cuongtv89ks/smart_wearable_controlling_system_by_hand_and_fingers_gestures/source/glove_python/seminar 18.pptx

## Seminar 18

UBIQUITOUS SENSOR NETWORK LABORATORY

Department of Electronics Engineering, Keimyung University
10th March 2017
By Tran Viet Cuong

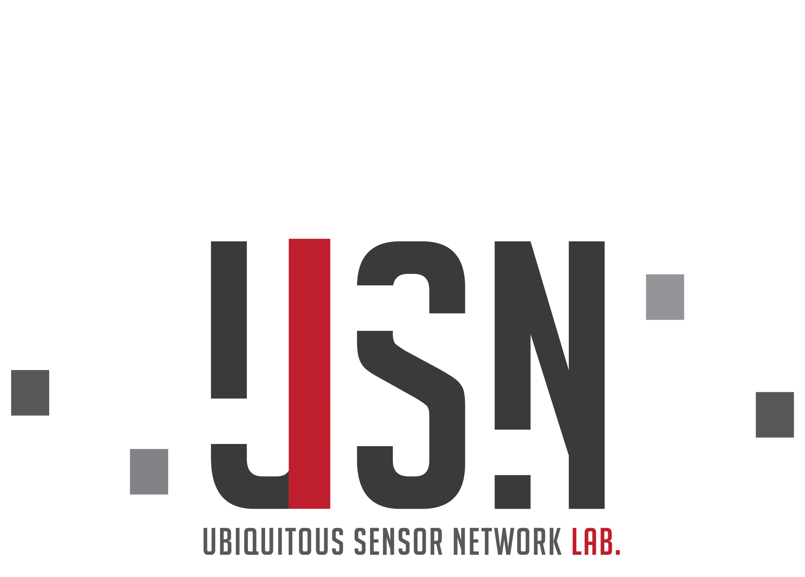
[picture p3: figure]

## Ring Gesture

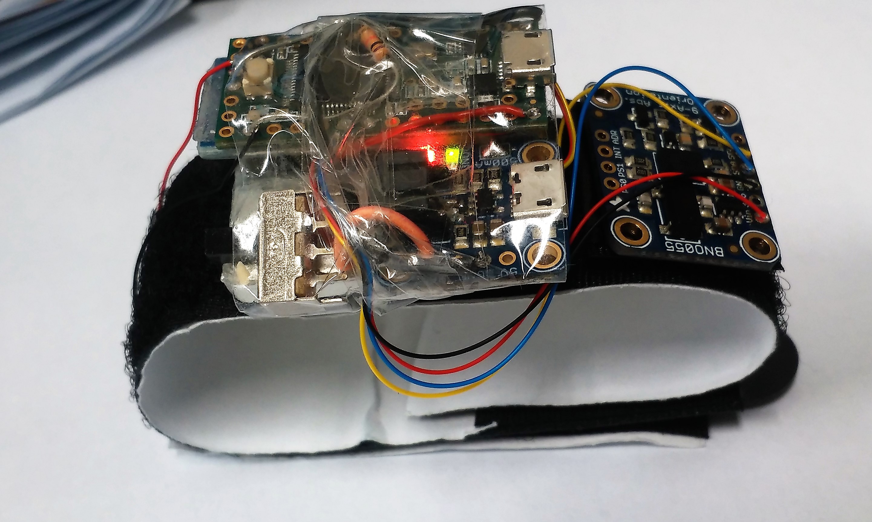
[picture p4: figure]
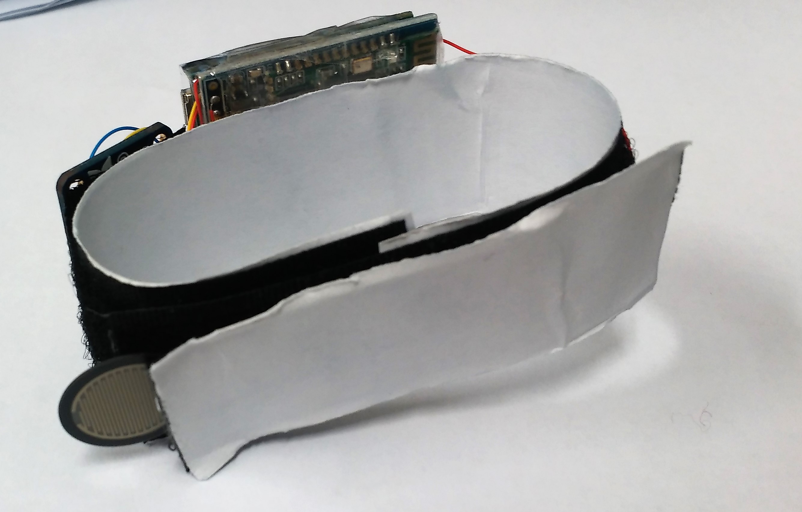
[picture p5: figure]

## The remaining work for ring gesture project:

- Clustering the data
- Try to make standalone system (ARM 32bit, C++)
- Application: Control quadcopter and Home Automation
- 3D printer and PCB board

## Next

- Finish paper
- Learn more deeply into C++, Qt platform
- Build quadcopter

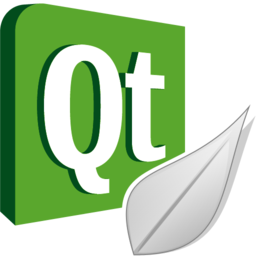
[picture p6: figure]
Image result for Qt platform

## THANK YOU!

UBIQUITOUS SENSOR NETWORK LABORATORY

## Any Questions ?

UBIQUITOUS SENSOR NETWORK LABORATORY
