cuongtv89ks/smart_wearable_controlling_system_by_hand_and_fingers_gestures/thesis/thesis_presentation.pdf

## Tran, Viet Cuong

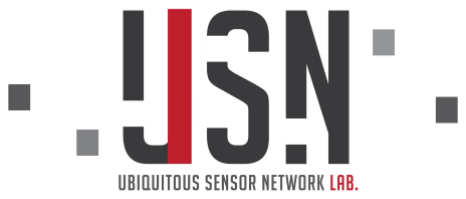
[picture p7: figure]

Department of Electronics Engineering, Keimyung University Daegu, Korea
25th October 2017

# Smart Wearable Controlling System by Hand and Finger Gestures

# Content

# •Introduction

# - System Design

# - Method

# - Experiments and Results

# - Conclusion & Future Work

Smart Wearable Controlling System by Hand and Fingers Gestures | 2

# Content

# •Introduction

# - Gesture Recognition

# - Literature View

# - Smart Wearable Controlling System

# - System Design

# - Evaluation Result

# - Conclusion & future work

Smart Wearable Controlling System by Hand and Fingers Gestures | 3

# Gesture Recognition

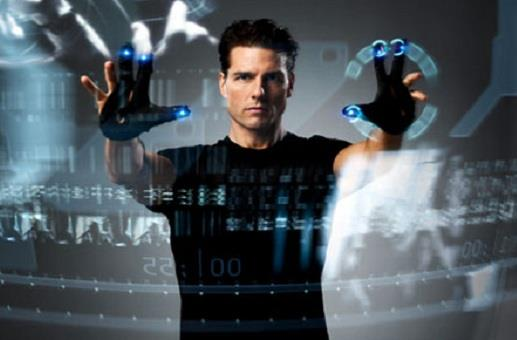
[picture p8: figure]
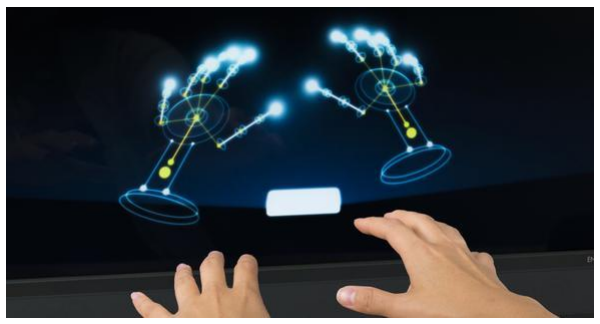
[picture p9: figure]

4

# - Gesture recognition has become on of the popular research fields that served as an

intelligent and a natural interface.

# - Exploring alternative ways to recognize the imitate human gestures to perform complex

and difficult tasks in various areas.

# - Wearable computing trends allowed devices to

be portable and smaller in size.

Smart Wearable Controlling System by Hand and Fingers Gestures

# Literature Review

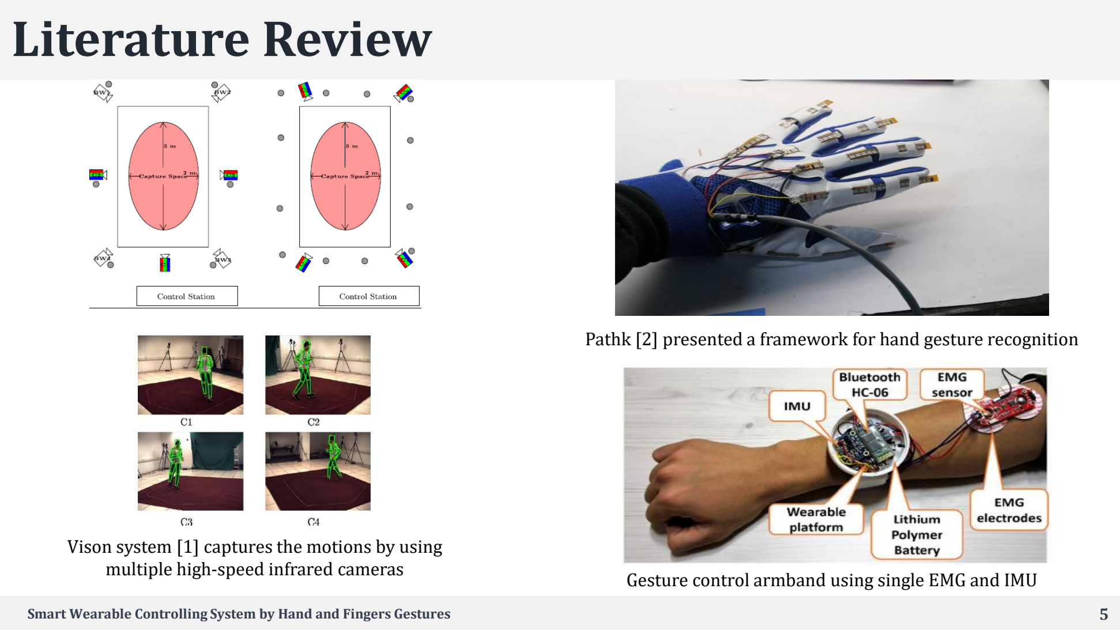
[picture p10: page 5]

5

## Vison system [1] captures the motions by using multiple high-speed infrared cameras

## Pathk [2] presented a framework for hand gesture recognition

## Gesture control armband using single EMG and IMU

# Smart Wearable Controlling System

6

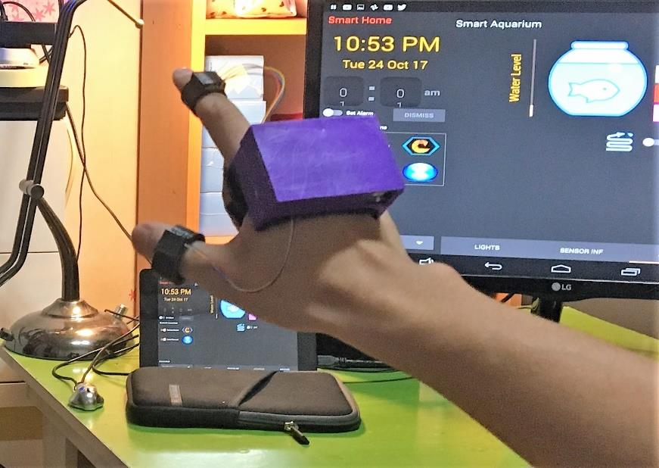
[picture p11: figure]

# Tend to wearable computing trend and high accuracy rate: - Utilizing only three IMUs - Recognizing 22 gestures

Content • Introduction • System Design • System Overview • Design of Hardware • Design of Software • Method • Experiments and Results • Conclusion & future work

7

# System Overview

8

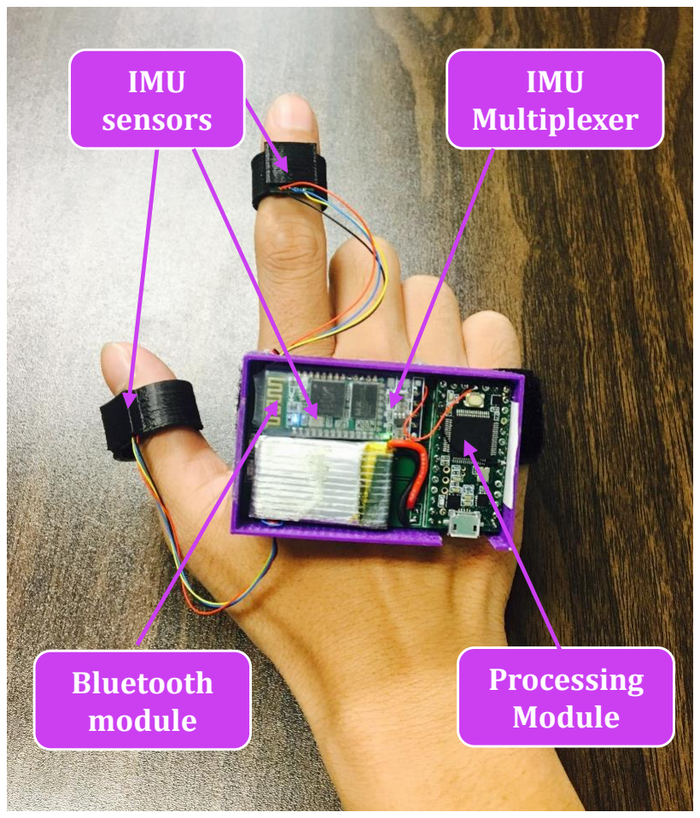
[picture p12: figure]
IMU sensors; IMU Multiplexer; Bluetooth module; Processing Module

# The system includes: - Sensor module - Processing module - Mobile device

# System Overview

9

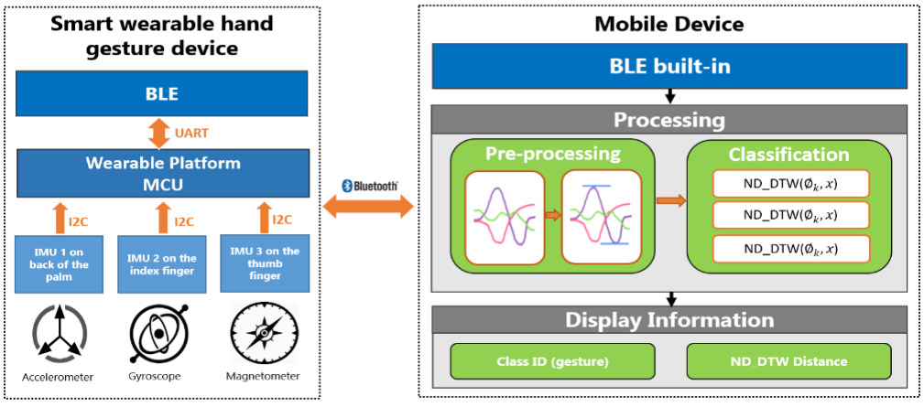
[picture p13: figure]

System design overview.

# System Overview

10

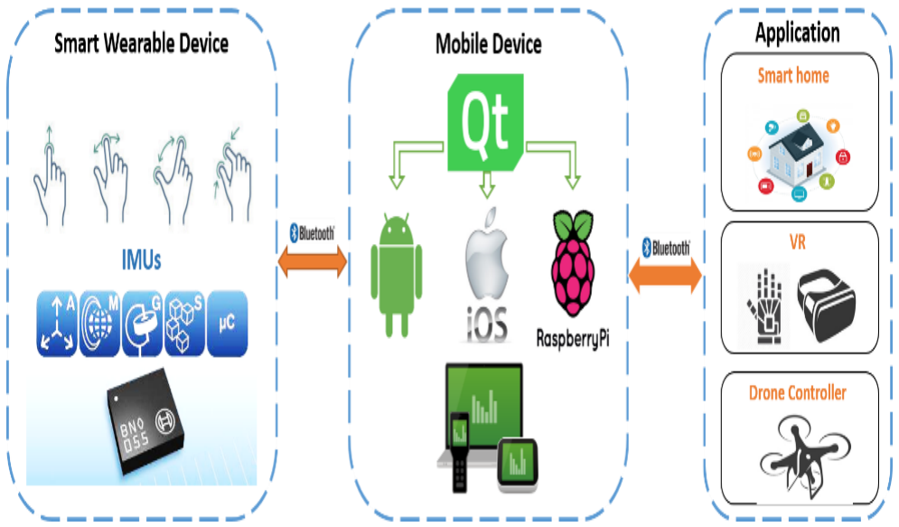
[picture p14: figure]

## Proposed smart wearable controller system can be applied to

various applications.

# - Qt cross platform software

# - Applying to various applications as home automation, games controller …

# Hardware

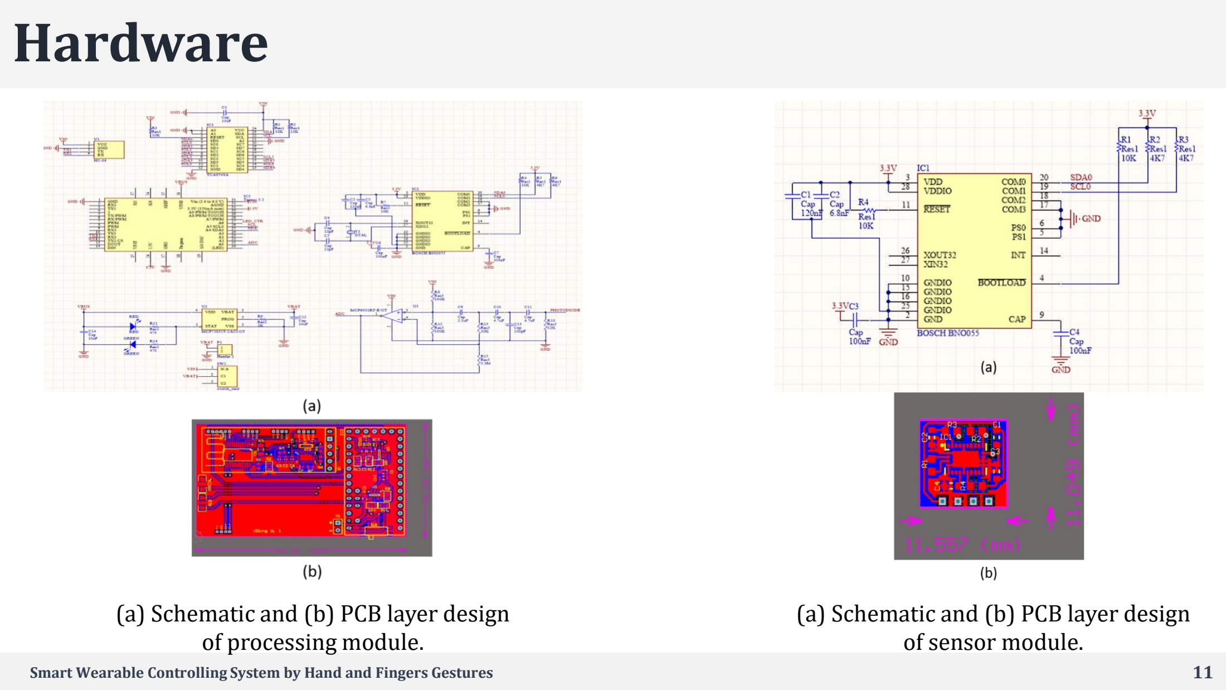
[picture p15: page 11]

11

## (a) Schematic and (b) PCB layer design

of sensor module.

## (a) Schematic and (b) PCB layer design

of processing module.

# Hardware

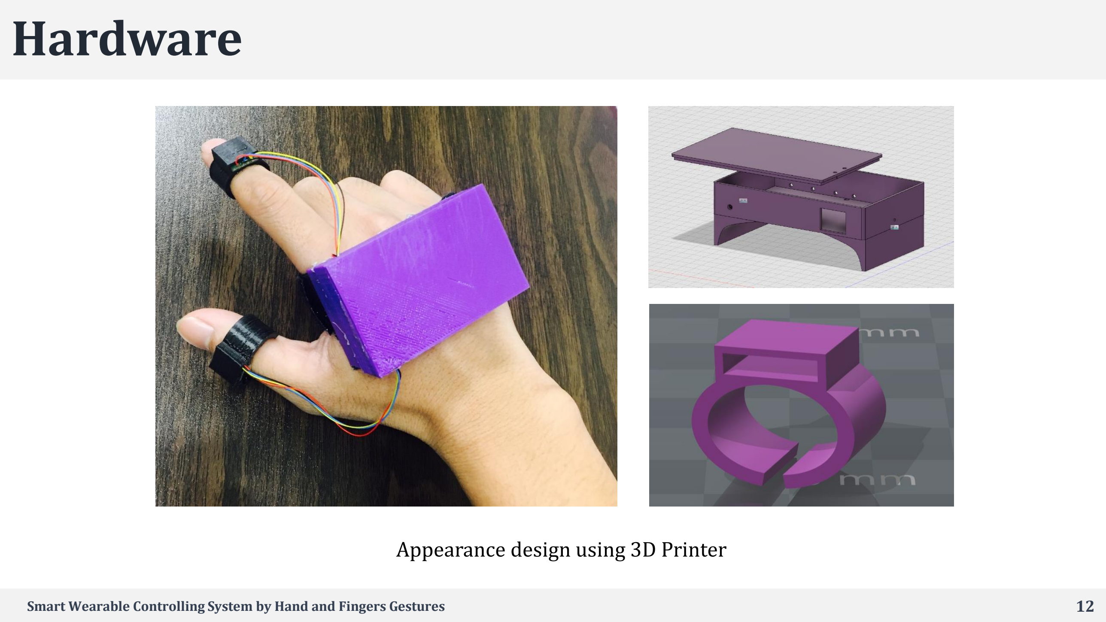
[picture p16: page 12]

12

## Appearance design using 3D Printer

# Design of Software

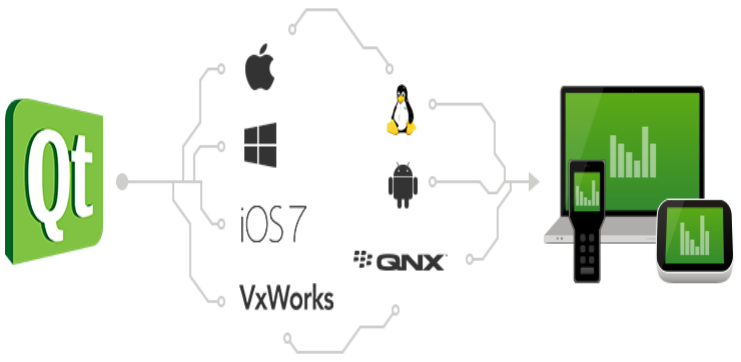
[picture p17: figure]

13

Qt cross-platform application development framework.

# - Cross-platform application framework

(Linux, OS X, Windows, Android, iOS).

- Framework written in C++.

# - GUI is written in QML instead of the

whole | application | whereas | the

# application’s backend is written in

C++.

# Design of Software

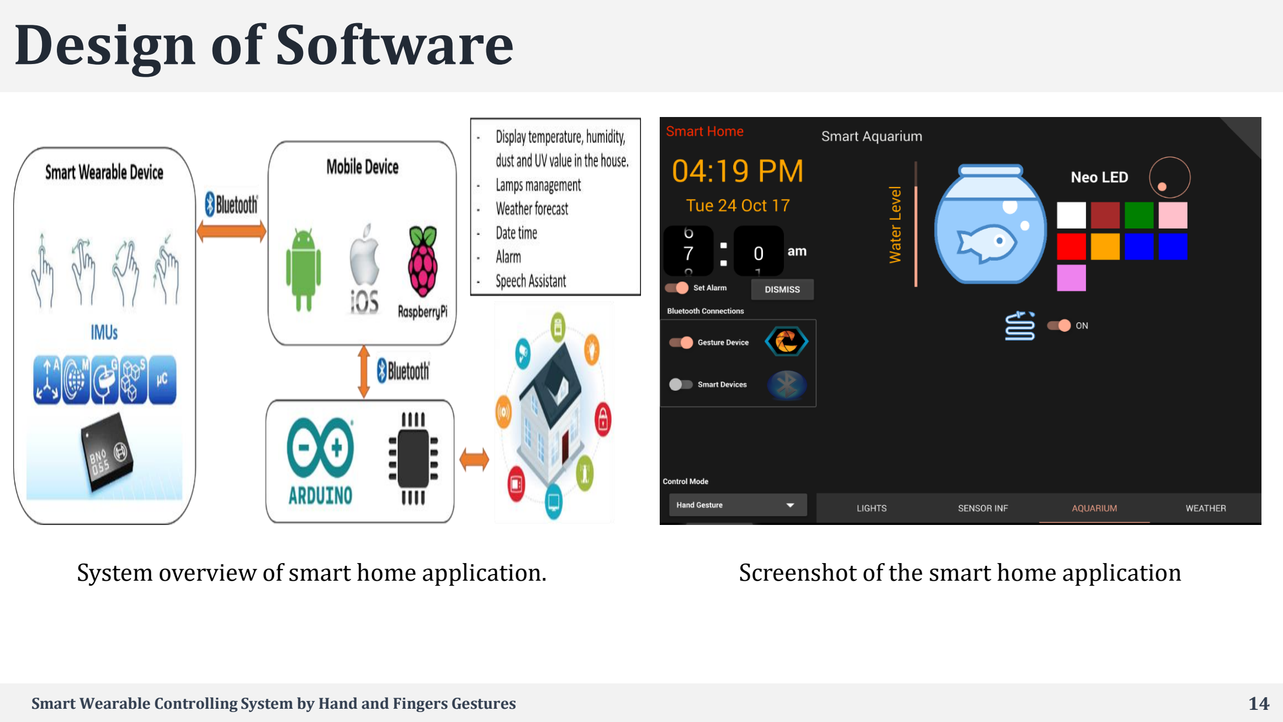
[picture p18: page 14]

14

System overview of smart home application. | Screenshot of the smart home application

# Design of Software

15

# Video Demo

Content • Introduction • System Design • Method • Dynamic Time Warping (DTW) • N Dimension – DTW • Pre-processing • Training • Classification Threshold • Experiments and Results • Conclusion & future work

Smart Wearable Controlling System by Hand and Fingers Gestures | 16

# Method

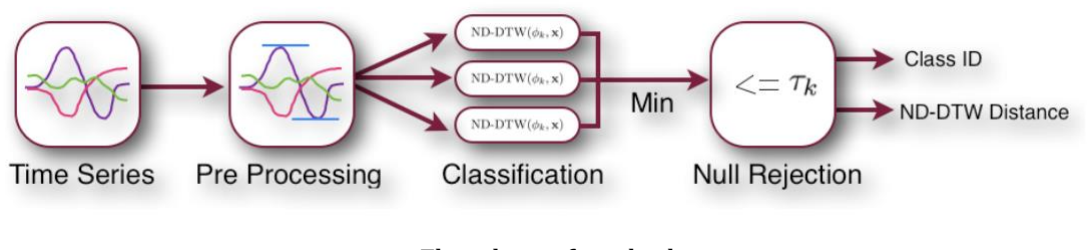
[picture p19: figure]

Smart Wearable Controlling System by Hand and Fingers Gestures | 17

# Flowchart of method

# Dynamic Time Warping (DTW)

18

# DTW is an algorithm that can compute the similarity between two time-series, even if the lengths of the time-series do not

match.

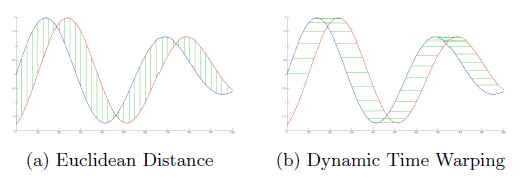
[picture p20: figure]

## Two identical time-series signals, with phase differences measured with (a) Euclidean

distance and (b) Dynamic Time Warping.

# DTW has been applied to

temporal sequences of video,

# audio, graphics data and gesture

recognition.

# Dynamic Time Warping (DTW)

## - Given two, one-dimensional, time-series:

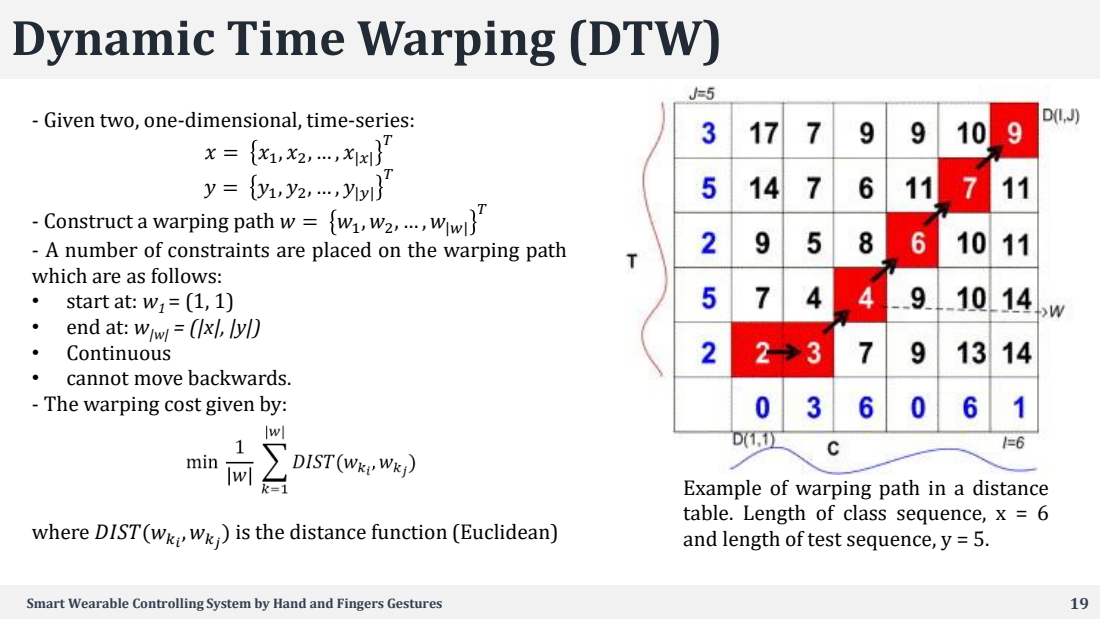
[picture p21: page 19]
, wkj

- Construct a warping path w = w1, w2, … , w|w
- A number of constraints are placed on the warping path
which are as follows:
• start at: w1= (1, 1)
• end at: w|w| = (|x|, |y|)
• Continuous
• cannot move backwards.
- The warping cost given by:

Example of warping path in a distance
table. Length of class sequence, x = 6
and length of test sequence, y = 5.

where DIST(wki

) is the distance function (Euclidean)

# N Dimension DTW

# - Computing the distance

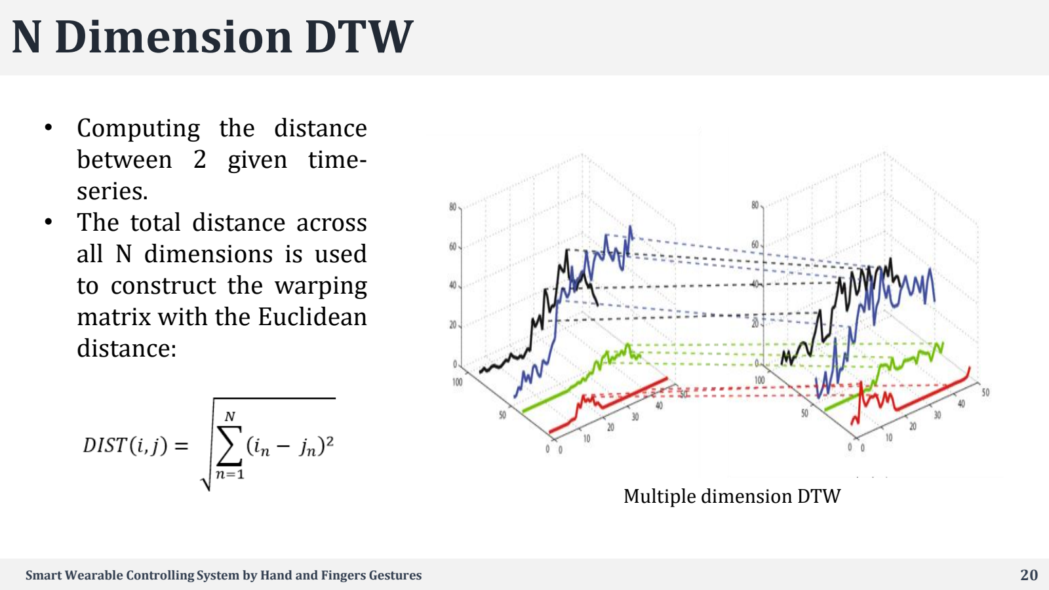
[picture p22: page 20]

20

## Multiple dimension DTW

# between 2 given time-

series.

# - The total distance across all N dimensions is used to construct the warping matrix with the Euclidean distance:

# Pre-processing

# - Accelerometer is reliable only in the long run, but

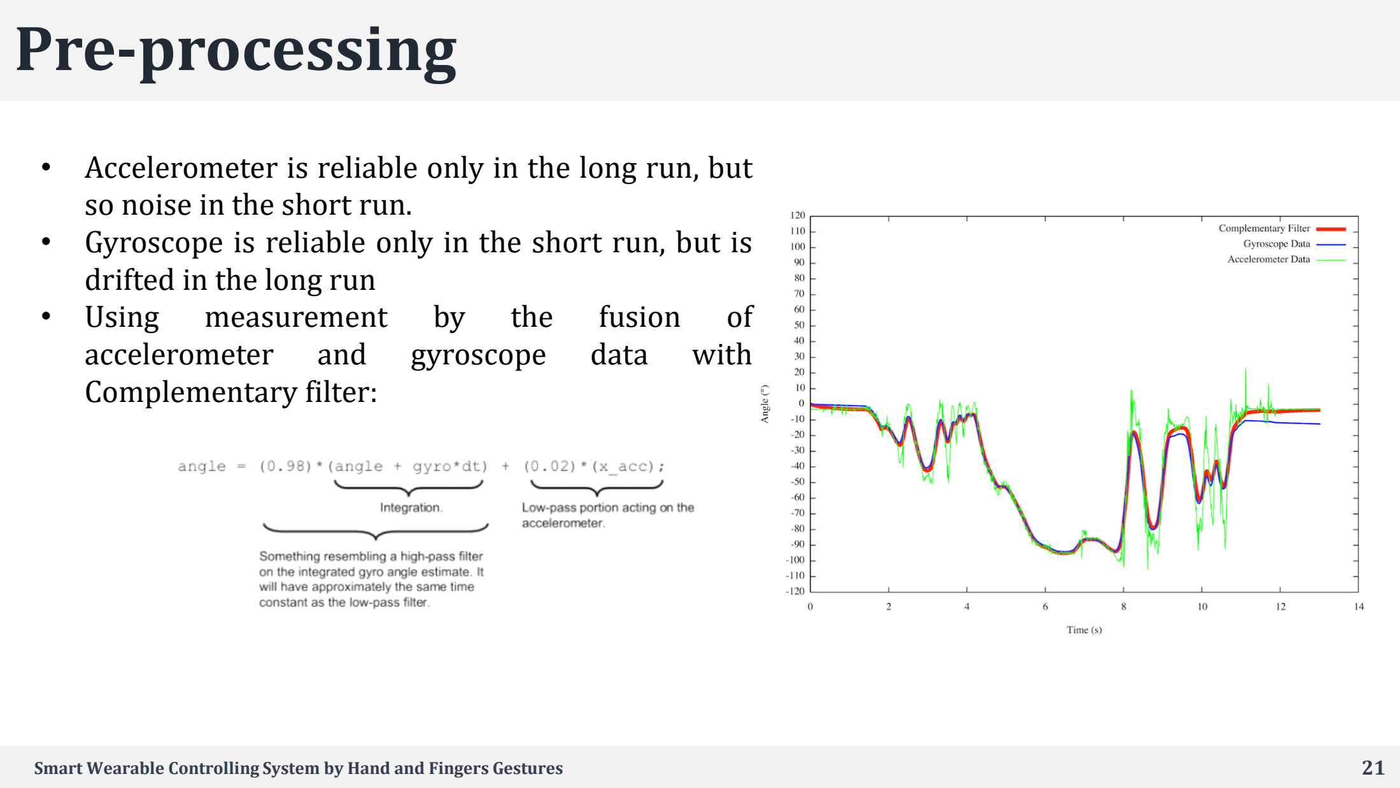
[picture p23: page 21]

21

so noise in the short run.

# - Gyroscope is reliable only in the short run, but is drifted in the long run

- Using | measurement | by | the | fusion | of
accelerometer | and | gyroscope | data | with

# Complementary filter:

# Training

22

# - Template is required to store all the intended gestures in database by recording Mg

# training samples for each of the G gestures

# - Each of G template can be found by computing distance each of Mg

# training samples

# - Searching for the training samples that provide the minimum warping distances when compare the other training samples in that class

# Classification Threshold

23

- The N-dimensional input time-series X is not matched with any of the gestures in the template
- Thus this false classification issue can be resolved by defining a classification threshold for each gesture in the template during the training phase.

## - The algorithm will indicate the particular gesture as no match:

## where d is the total normalized warping distance

### γ could be initially set to any number during the training phase and later be adjusted by the user

# Content

# - Introduction

# - System Design

# - Method

# - Experiments and Results

# - Experiment Setup

# - Results and Discussions

# - Conclusion & future work

Smart Wearable Controlling System by Hand and Fingers Gestures | 24

# Experiment Setup

# - Six right handed subjects are voluntarily

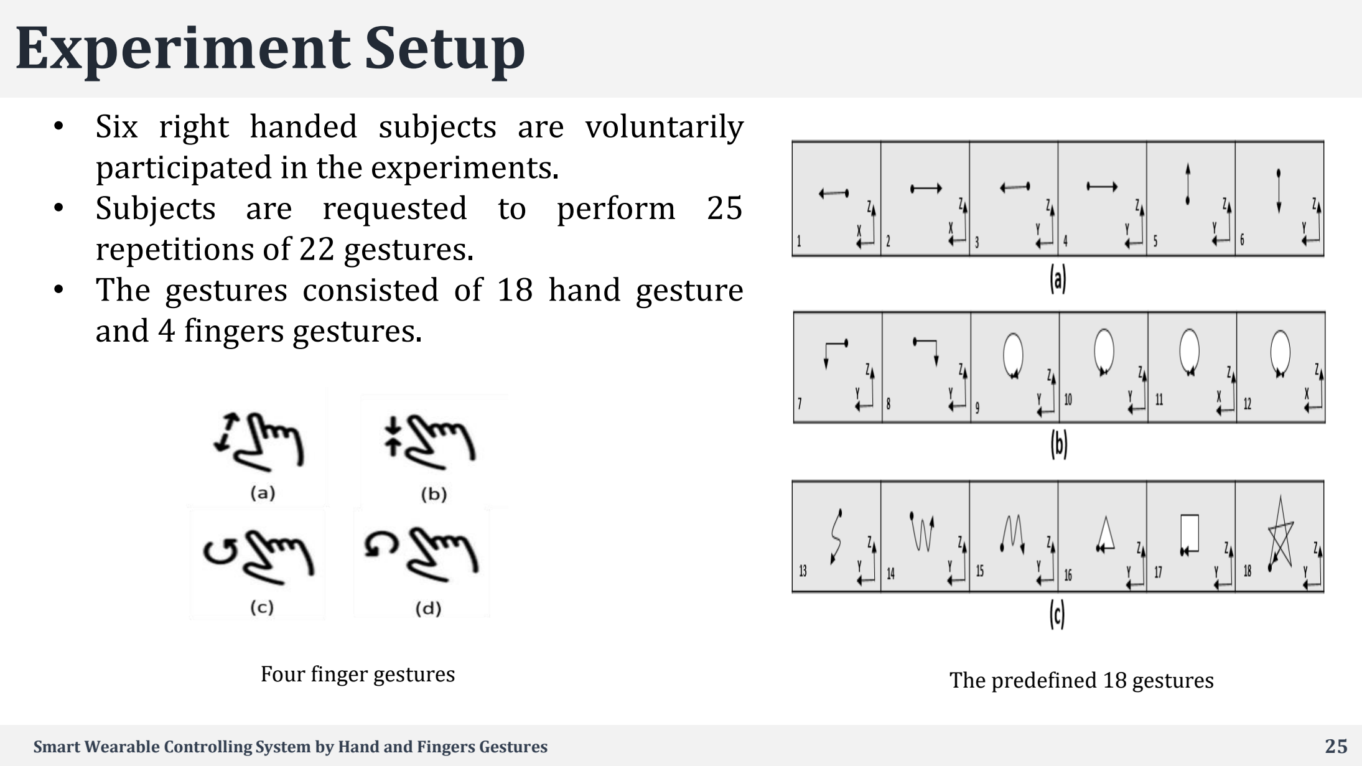
[picture p24: page 25]

25

participated in the experiments.

# - Subjects are requested to perform 25

repetitions of 22 gestures.

# - The gestures consisted of 18 hand gesture

and 4 fingers gestures.

## The predefined 18 gestures Four finger gestures

# Experiment Setup

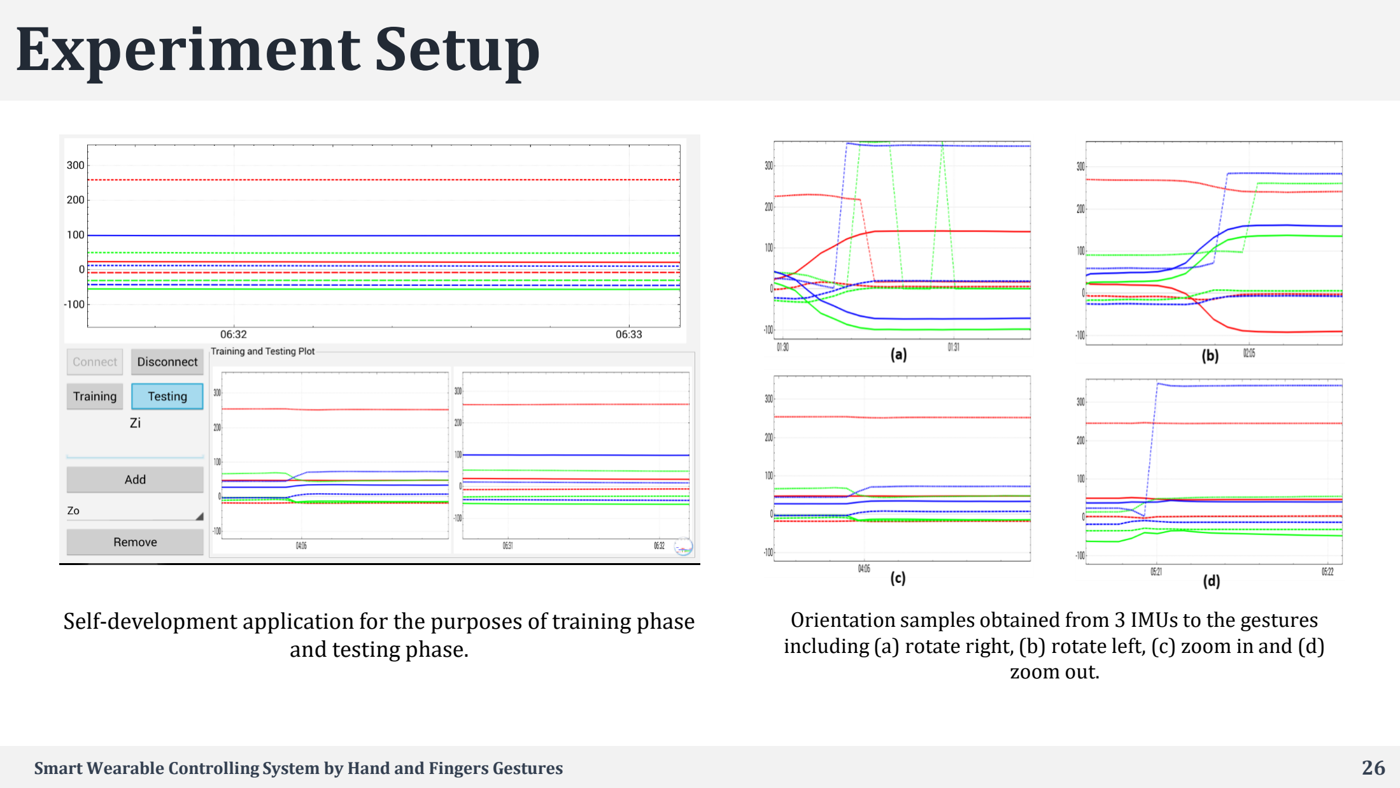
[picture p25: page 26]

26

### Orientation samples obtained from 3 IMUs to the gestures including (a) rotate right, (b) rotate left, (c) zoom in and (d)

zoom out.

## Self-development application for the purposes of training phase

and testing phase.

# Result and Discussion

27

# - Experiments are conducted to

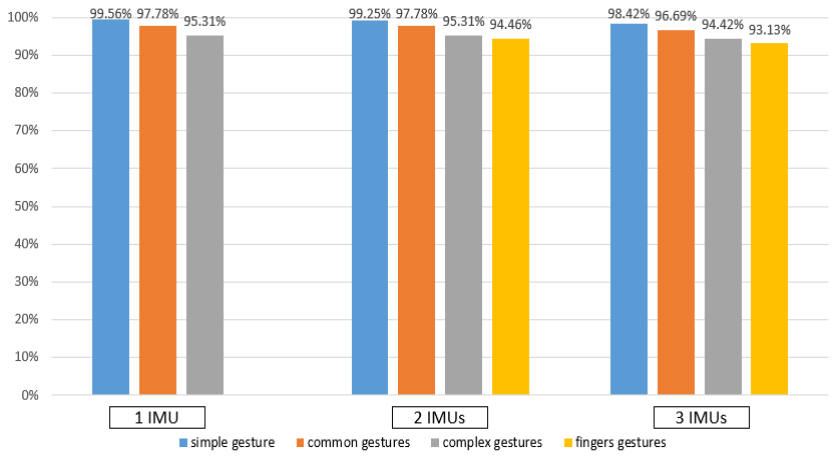
[picture p26: figure]

# validate the gesture recognition accuracy rate utilizing the ND

# DTW algorithm. • The impact to accuracy rate

# based on the quantity of IMUs used are also taken into consideration. • The ND-DTW model was trained

# using

6

# -fold cross validation method

# Result and Discussion

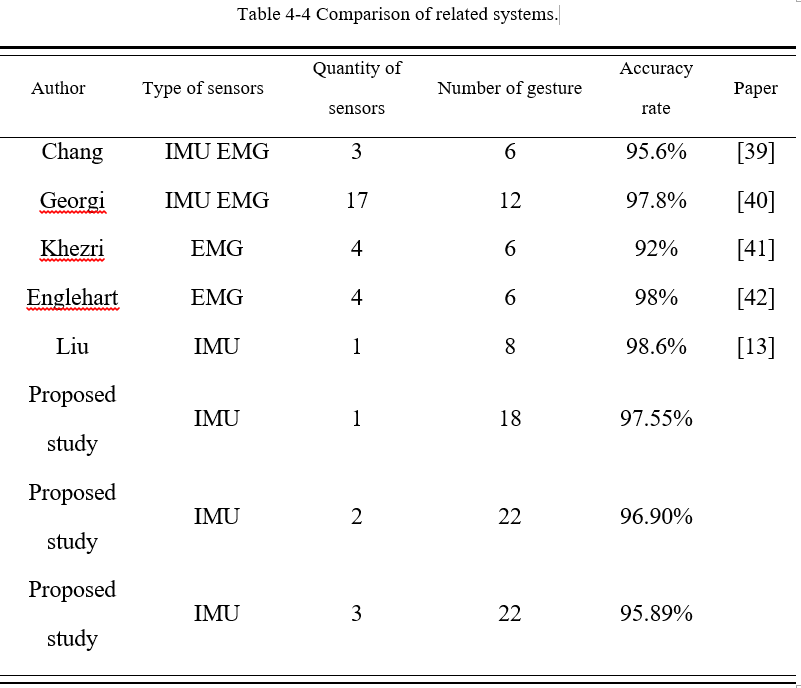
[picture p27: figure]

Smart Wearable Controlling System by Hand and Fingers Gestures | 28

# Content

# - Introduction

# - System Design

# - Method

# - Experiments and Results

# - Conclusion & future work

# - Conclusion

# - Future Work

Smart Wearable Controlling System by Hand and Fingers Gestures | 29

# Conclusion

# - Focused on the design and implementation of smart wearable controller

system using hand and fingers for gesture recognition.

# - The system utilized 3 IMUs sensors, to recognize total of 22 pre-defined gestures with DTW algorithm with low cost implementation and high

accuracy rate.

# - The study evaluated the IMUs quality impacted to the accuracy rate of

system.

# - System performed well with low energy consumption of 10 hours with 3.7V 240mA battery

Smart Wearable Controlling System by Hand and Fingers Gestures | 30

# Future Work

# - Optimization of PCB design in term of size and dimensionality to reduce

power consumption and its wearable comfortability.

# - Implementation of recognition algorithm in embedded hardware as

standalone system which is compatible to different software platforms.

# - Recognition of more complex gestures that involved three dimensional

gestures by utilizing hand and fingers motion.

# - Inclusion of more functionalities for various applications and allow gestures

self-customization by users.

Smart Wearable Controlling System by Hand and Fingers Gestures | 31

# THANK YOU!

UBIQUITOUS SENSOR NETWORK
LABORATORY

Q&A

UBIQUITOUS SENSOR NETWORK
LABORATORY

# Reference
