cuongtv89ks/smart_wearable_controlling_system_by_hand_and_fingers_gestures/source/glove_python/zoom.png

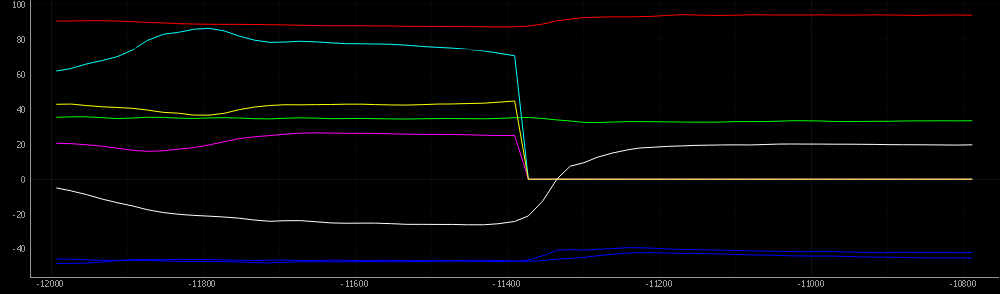
source/glove_python/zoom.png
