cuongtv89ks/smart_wearable_controlling_system_by_hand_and_fingers_gestures/source/mobile_apps/gestureApp/images/wallpapers/4.jpg

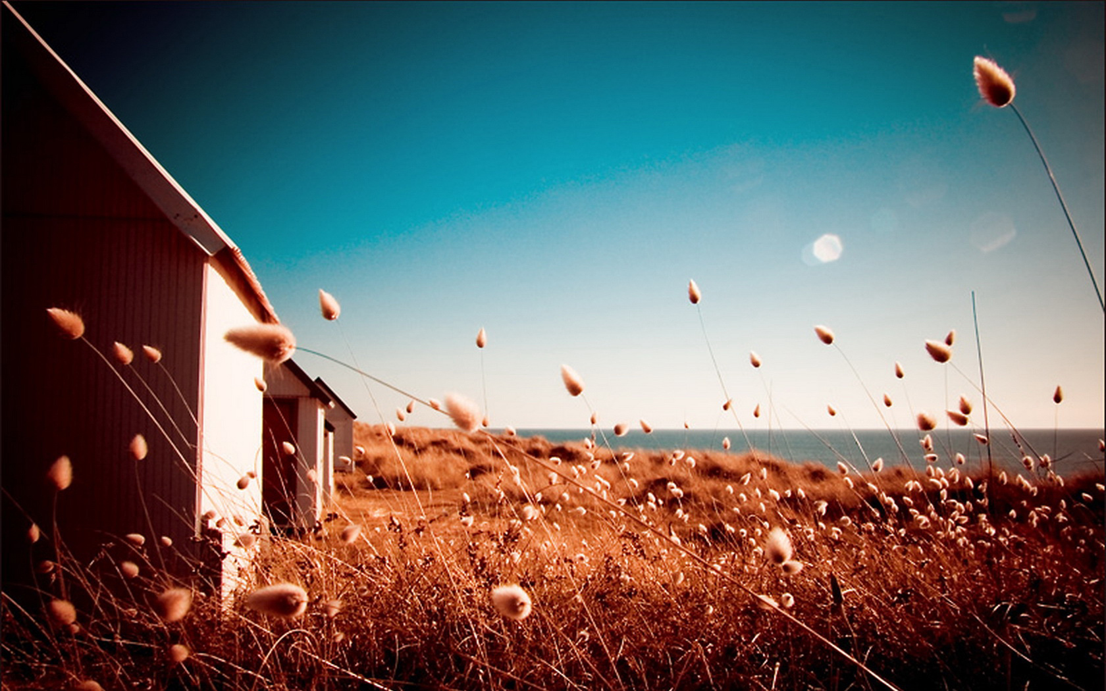
source/mobile_apps/gestureApp/images/wallpapers/4.jpg
