cuongtv89ks/smart_wearable_controlling_system_by_hand_and_fingers_gestures/source/glove_python/IMU_3D_simulation/hand.obj

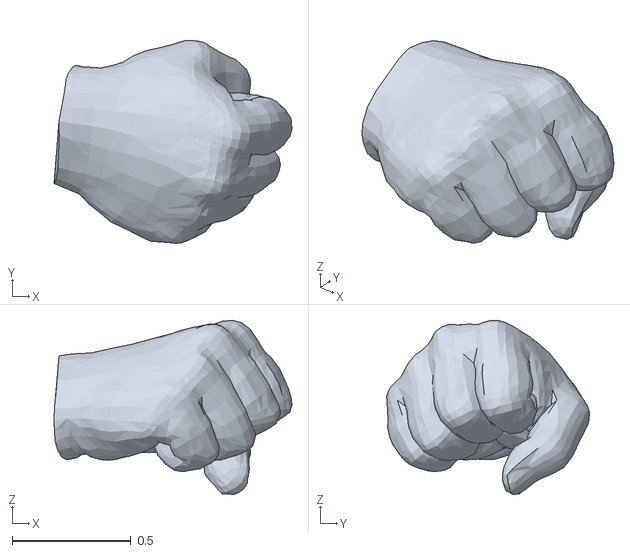
[picture p48: CAD file, 2019-03-06]
source/glove_python/IMU_3D_simulation/hand.obj
1.00 x 0.852 x 0.733
