cuongtv89ks/smart_wearable_controlling_system_by_hand_and_fingers_gestures/schematic/gloveSch.pdf

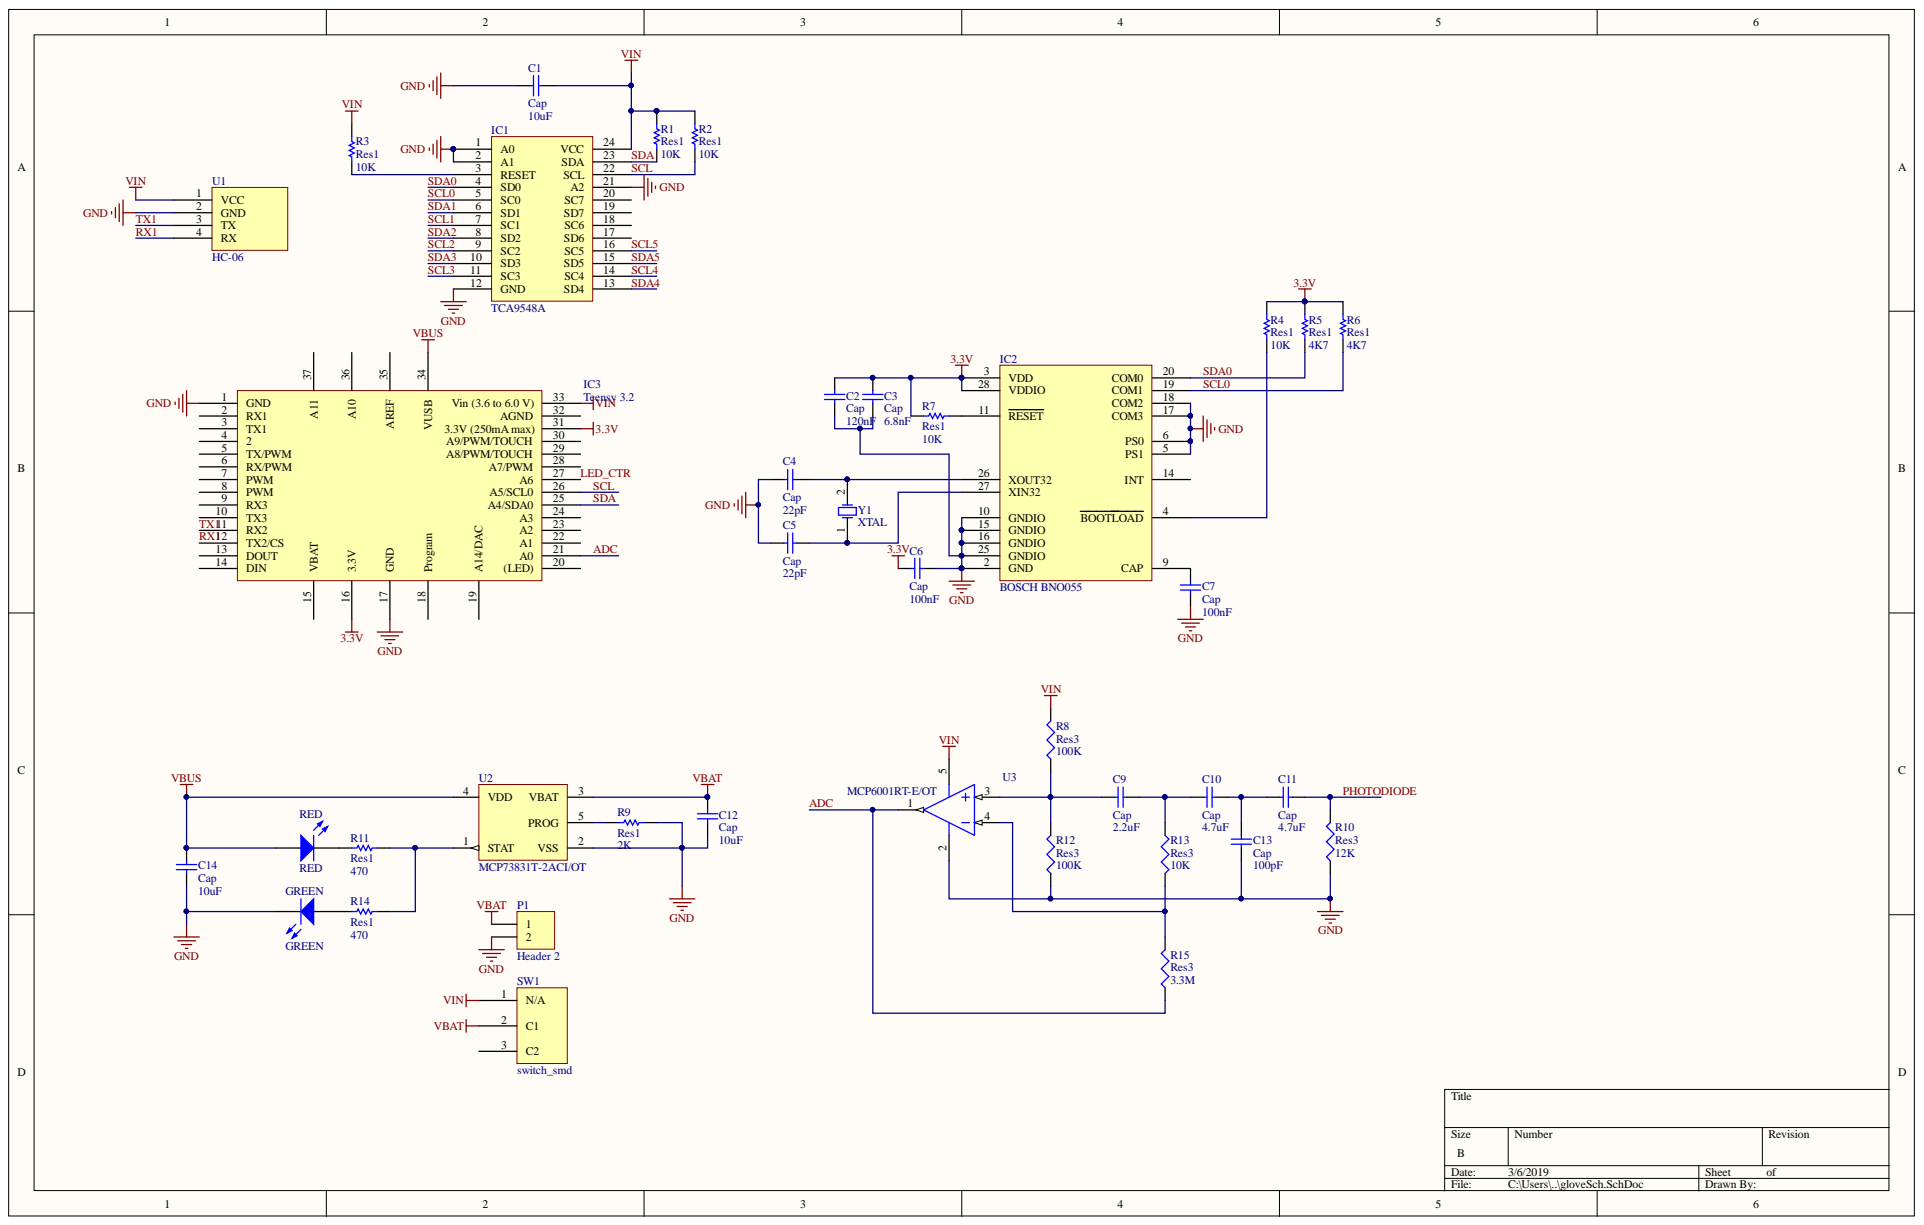
[picture p63: page 1]

3.3V C6 | GNDIO 25

GND 2

Size B | Number | Revision

Date: 3/6/2019 | Sheet of
File: C:\Users\..\gloveSch.SchDoc | Drawn By:

# Board S
