cuongtv89ks/smart_wearable_controlling_system_by_hand_and_fingers_gestures/schematic/imuSch.pdf

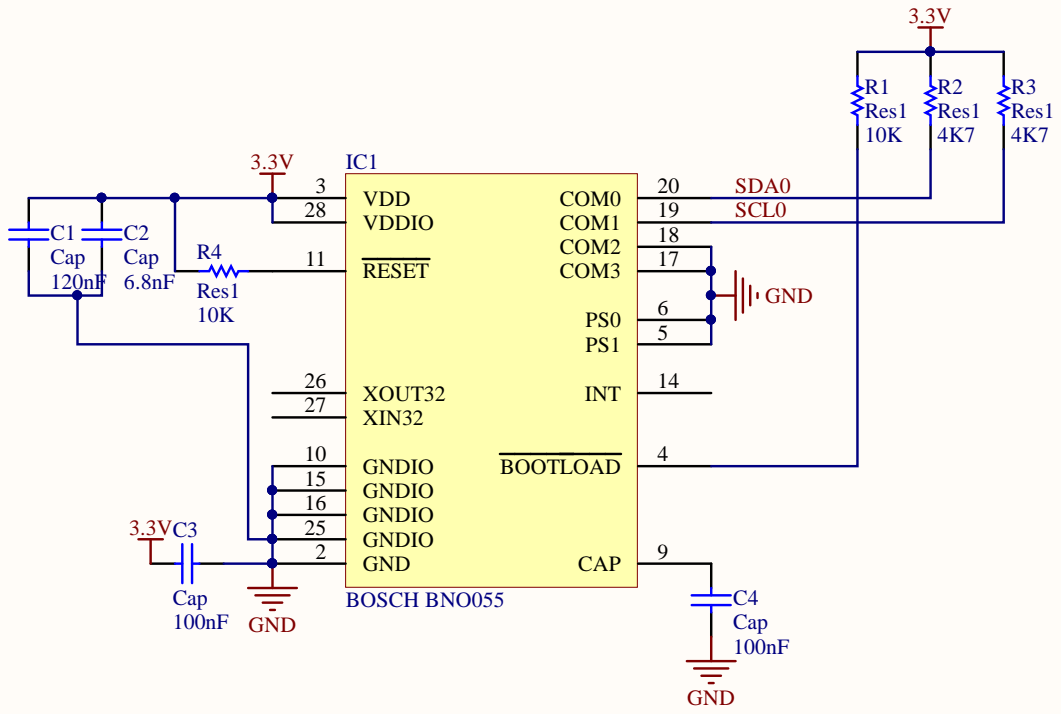
[picture p64: page 1]

Comment | Description | Designator | Footprint | LibRef | Quantity

Cap | Capacitor | C1, C2, C3, C4 | CAP0603 | Cap | 4
BOSCH BNO055 | | IC1 | BOSCH LGA-28 5.2x3.8MM | BOSCH BNO055 | 1

Res1 | Resistor | R1, R2, R3, R4 | RES0603 | Res1 | 4
